williamjvest/milk-crate-dividers/README.md

# Milk crate dividers (Juggernaut 24 qt)

3D-printed clips that hold 1/4" plywood dividers in Juggernaut 24 quart milk crates. Each divider gets two **wall clips**, one on each side wall, and one **floor insert**. Everything plugs into the crate's own holes, so there's no glue and no drilling, and the crates still stack.

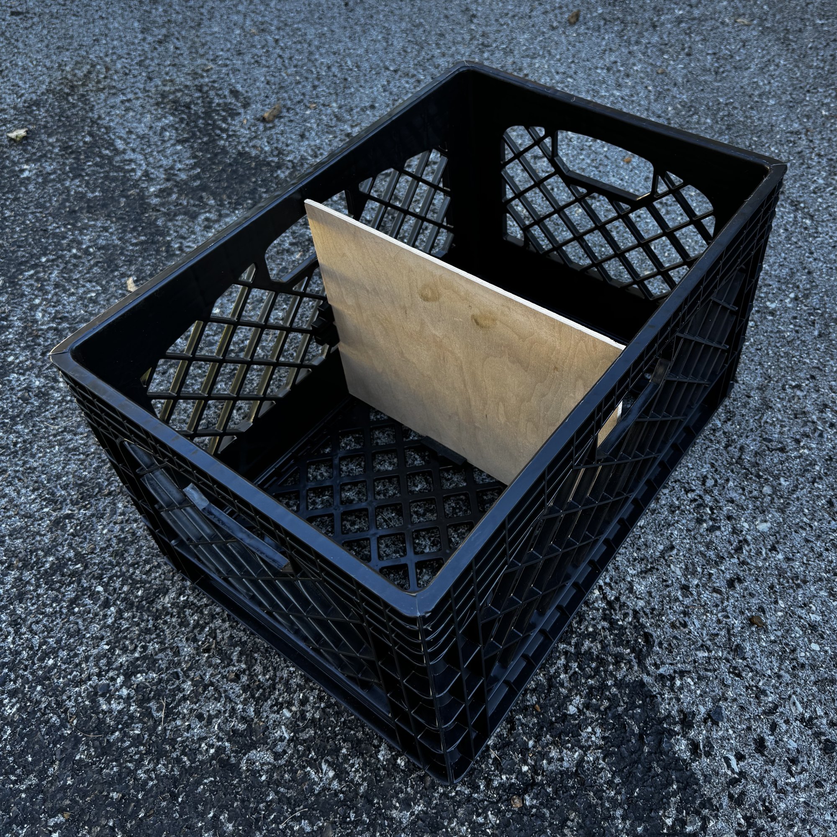
[picture p1: images/crate-angle.jpg]
A divider in a Juggernaut 24 qt crate


| | |
|---|---|
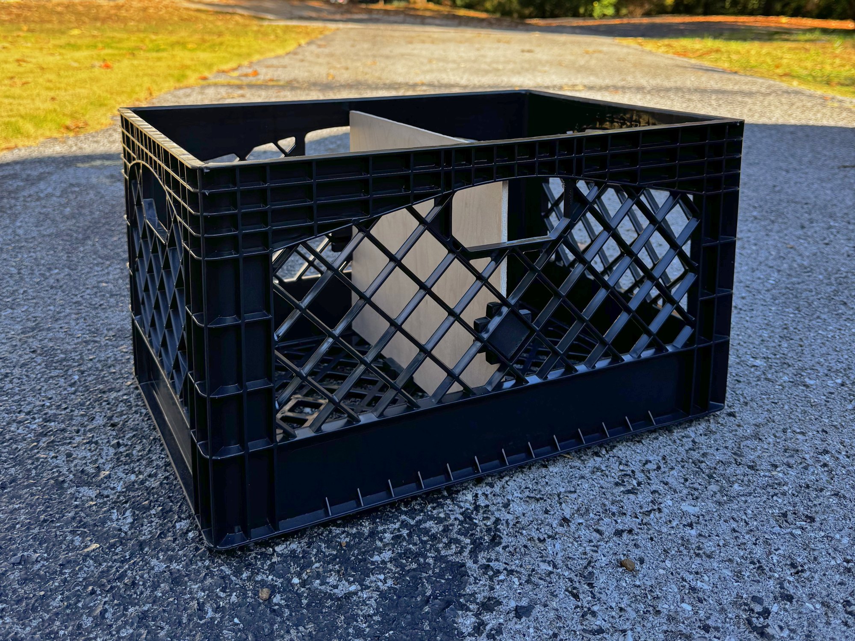
[picture p2: images/crate-side.jpg]
The crate from the side, divider in place
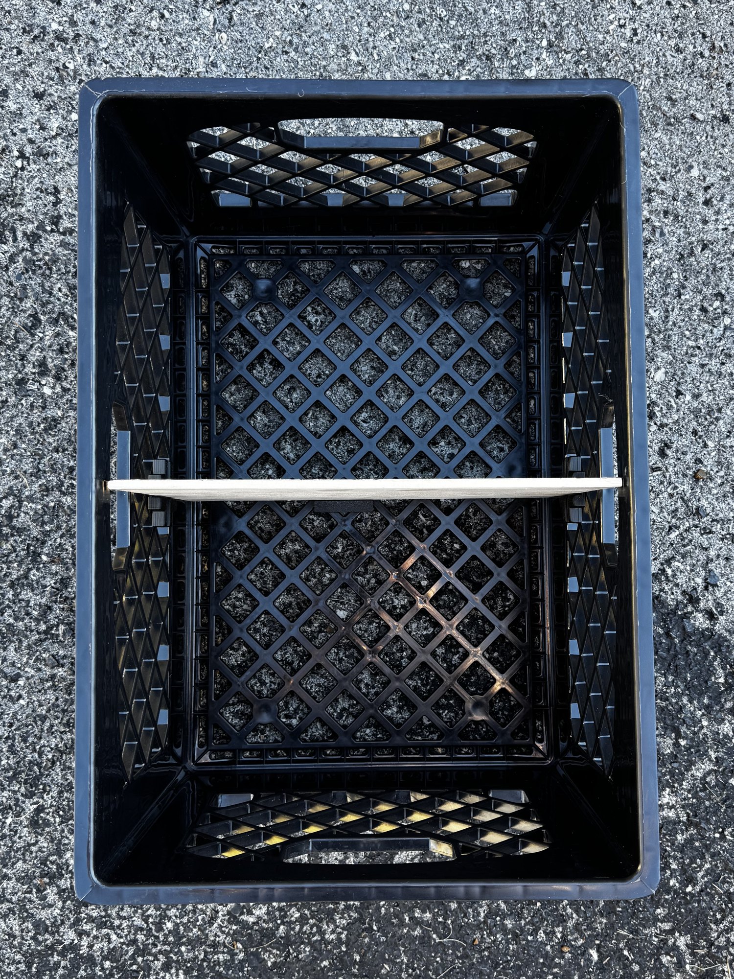
[picture p3: images/crate-top.jpg]
The crate from above: the board spans side wall to side wall
|  |  |

## What you need

| | |
|---|---|
| **Crates** | [Juggernaut 24 Quart Storage Crate, 6 pack](https://www.amazon.com/dp/B0D4BWD3GS) (Amazon) |
| **Board** | [1/4" x 4' x 8' Maple Square Sanded Plywood](https://www.lowes.com/pd/SoyStrong-NAF-1-4-in-HPVA-Maple-Plywood-Application-as-4-x-8/1000096494) (Lowe's item #786165, model #712807, about $37). It's an oversized 48-1/2" x 96-1/2" panel and actually 0.203" thick (5.2-5.4 mm). |
| **Per divider** | 1 board, 2 wall clips, 1 floor insert |
| **Printer** | Any FDM printer. PLA or PLA-CF. |

## Boards: 12" wide x 9-7/8" tall, 36 per sheet

Each board spans the crate's width, side wall to side wall, and splits it front to back. At 9-7/8" tall it sits just under the rim, so the crates still stack. The 4x8 sheet gives 4 rips of 12" with 9 boards each.

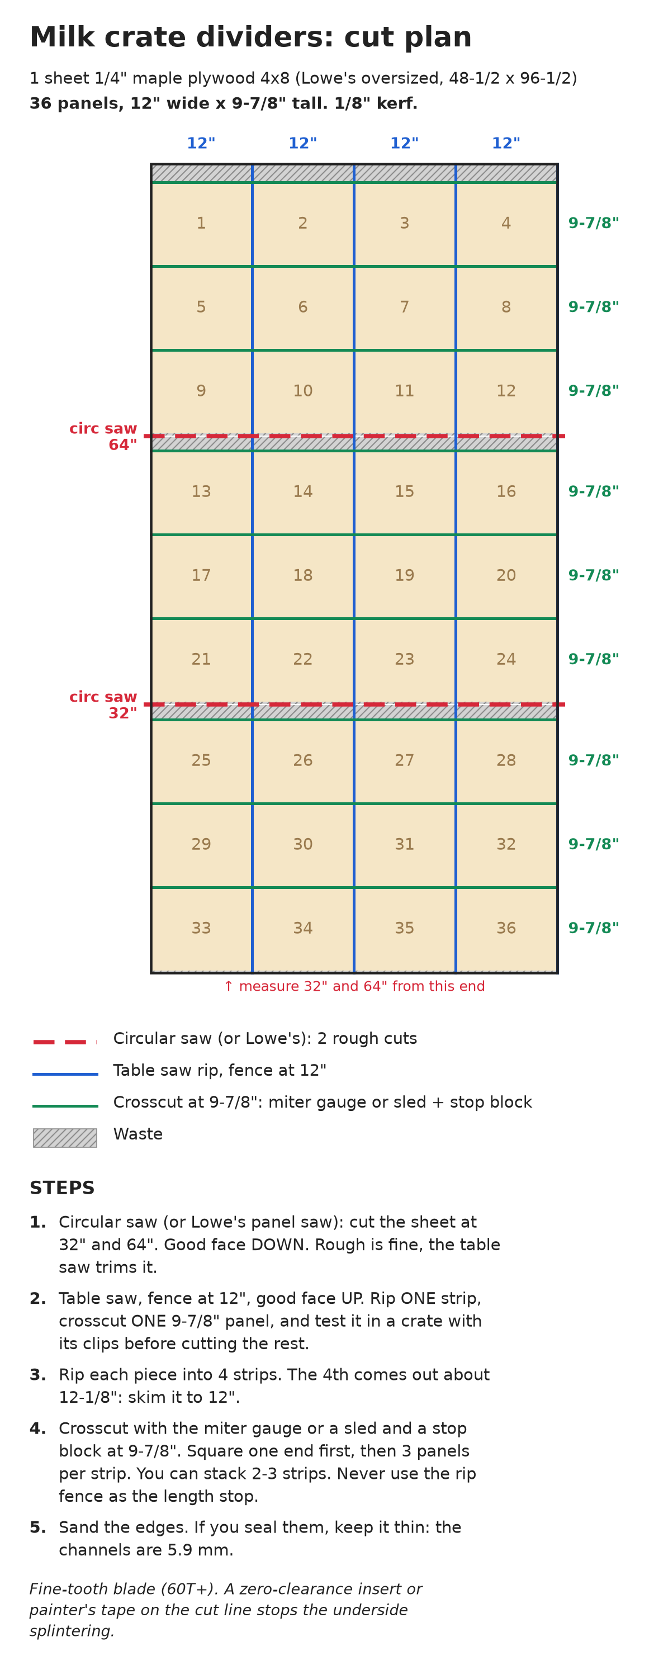
[picture p4: images/cut-plan.png]
Cut plan: 36 boards from one sheet


## Printing

Every print file is already oriented: channel face down, plug up. They need no supports.

- **3MF** is the one to use. It records units, so every slicer reads it at the right size (Orca, Bambu Studio, PrusaSlicer, Elegoo, Cura).
- **STL** works anywhere.
- **STEP**, in [`step/`](step), is for opening the parts in CAD.

| Part | 3MF | STL | Each (0.4 nozzle, 0.2 mm, PLA) |
|---|---|---|---|
| Wall clip | [`3mf/wall-clip.3mf`](3mf/wall-clip.3mf) | [`stl/wall-clip.stl`](stl/wall-clip.stl) | ~33 min, 12 g |
| Floor insert | [`3mf/floor-insert.3mf`](3mf/floor-insert.3mf) | [`stl/floor-insert.stl`](stl/floor-insert.stl) | ~30 min, 11 g |

- Print both as-is. Each part's two small "ears" carry the plug square up through the body, so nothing prints over air. The only bridge is the channel ceiling, 5.9 mm across.
- Print one of each and test-fit it in your crate before running a full plate. Crates and filaments vary.
- Six walls or 100% infill makes them stiff. Ours are printed in PLA and PLA-CF on an Elegoo Centauri Carbon.

## How it fits

| Wall clip | Floor insert |
|---|---|
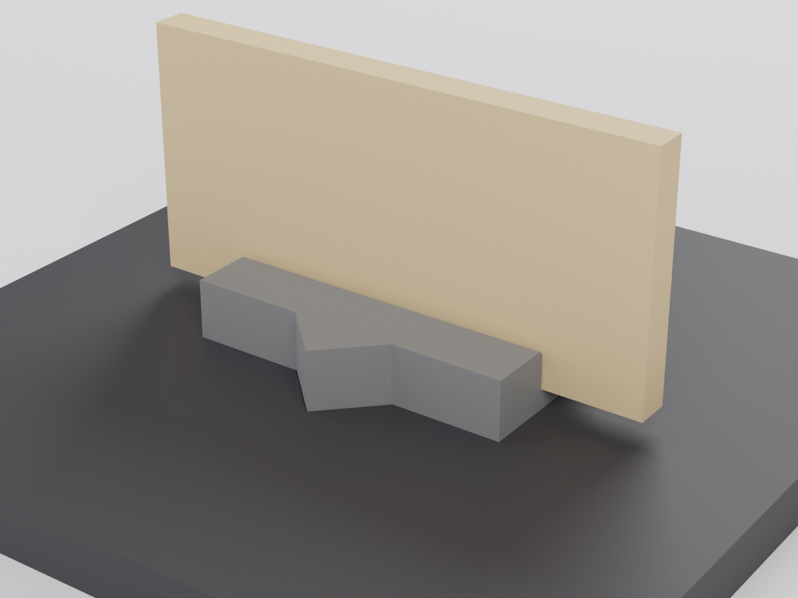
[picture p5: images/wall-clip-in-use.jpg]
Wall clip holding a board
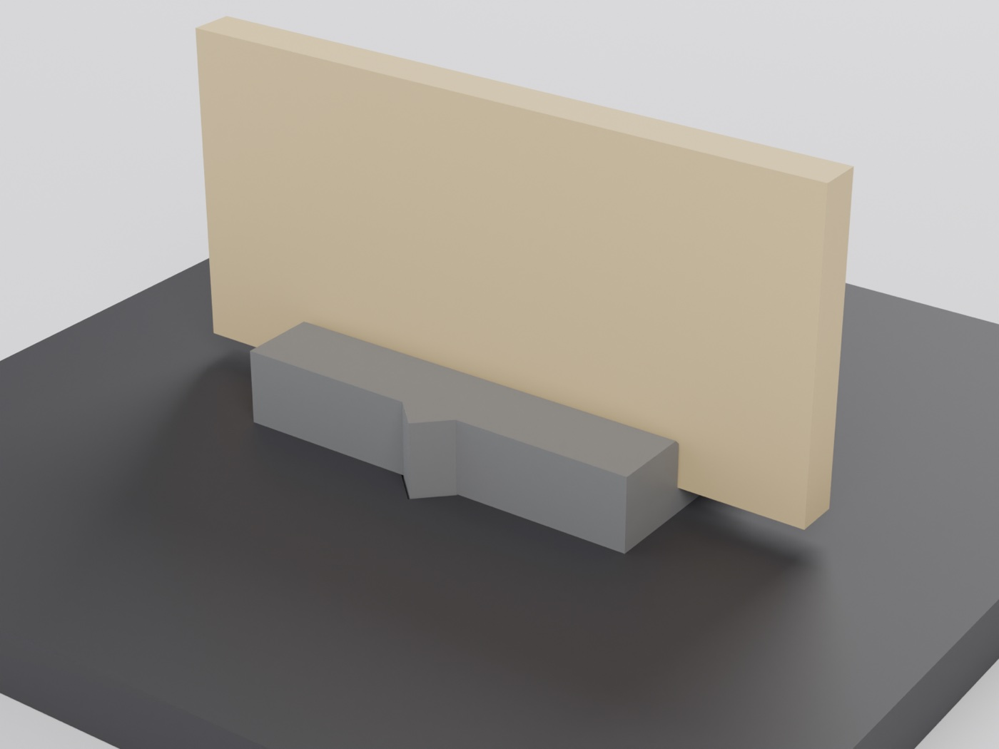
[picture p6: images/floor-insert-in-use.jpg]
Floor insert holding a board
|  |  |

| | Wall clip | Floor insert |
|---|---|---|
| Plug (a square turned 45° to match the crate's diamond holes) | 29.65 mm (1.17") across the flats | 23.4 mm (0.92") for the 23.9 mm floor holes |
| Channel | 5.9 mm wide x 6 mm deep | 5.9 mm wide x 6 mm deep |
| Body | 50 x 26 mm, 9 mm thick (42 mm across the ears) | 50 x 26 mm, 9 mm thick (33 mm across the ears) |

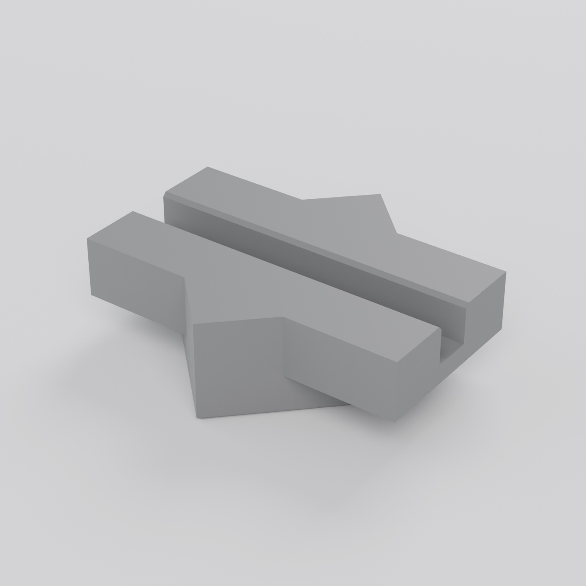
[picture p7: images/wall-clip-top.jpg]
Wall clip, channel side
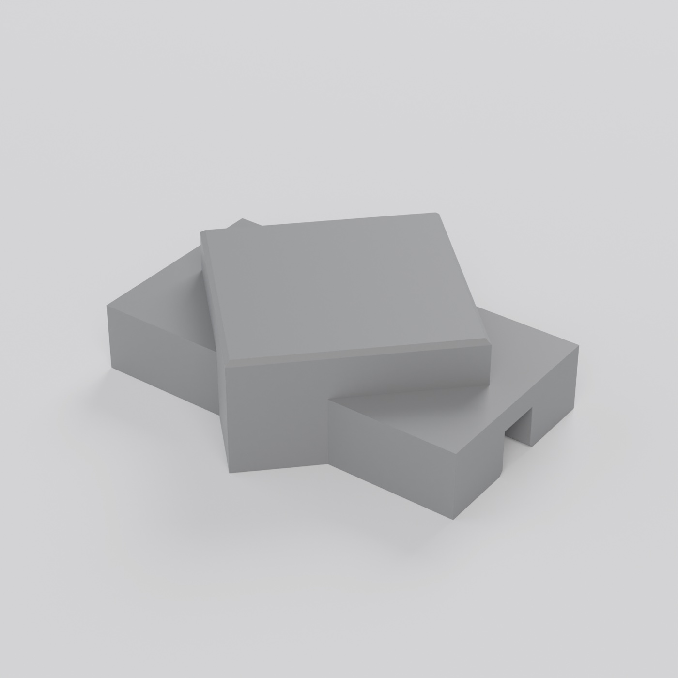
[picture p8: images/wall-clip-underside.jpg]
Wall clip, plug side
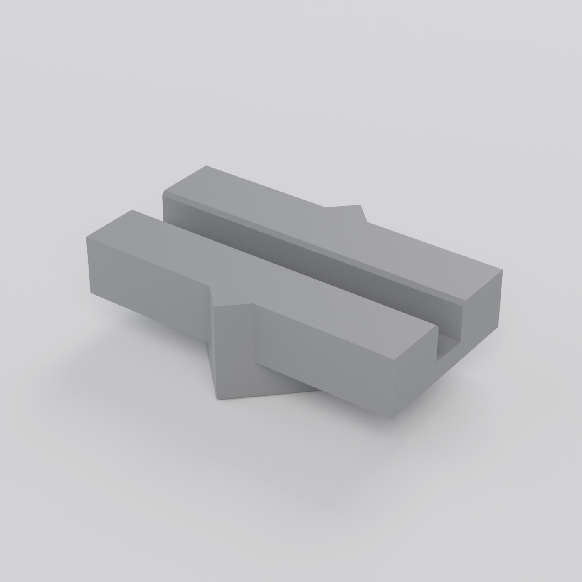
[picture p9: images/floor-insert-top.jpg]
Floor insert, channel side
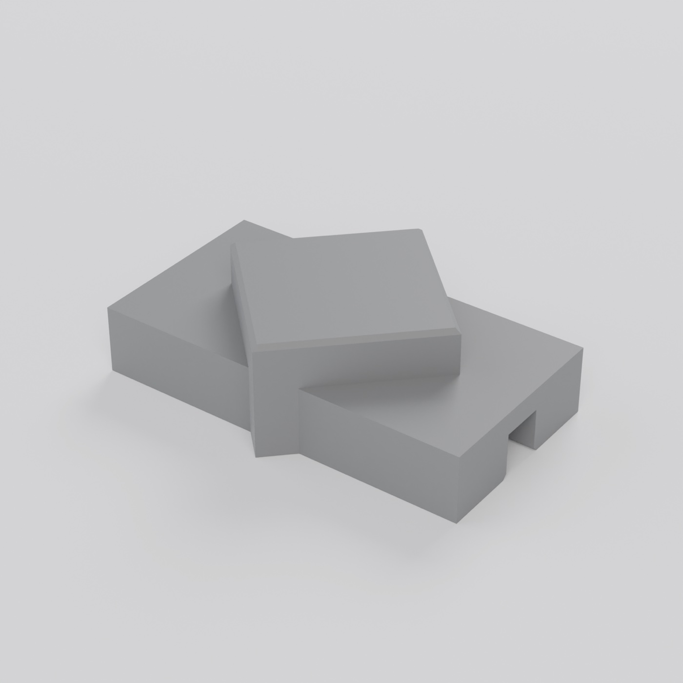
[picture p10: images/floor-insert-underside.jpg]
Floor insert, plug side
|  |  |  |  |
|---|---|---|---|
| Wall clip, channel side | Wall clip, plug side | Floor insert, channel side | Floor insert, plug side |

- **Plug fit:** the floor insert's plug is snug by design. If yours won't go in, sand the flats lightly, or drop `PLUG` by 0.1-0.2 mm in the script.
- **Channel:** 5.9 mm leaves about 0.3 mm a side for the 1/4" maple. For 6 mm material (Baltic birch, Sintra, BCX pine), set `SLOT_W = 6.5` in both scripts.
- **Height:** the floor insert lifts the board 3 mm off the crate floor.
- **Shelves:** the plugs are square, so a wall clip turned 90° holds a horizontal board.

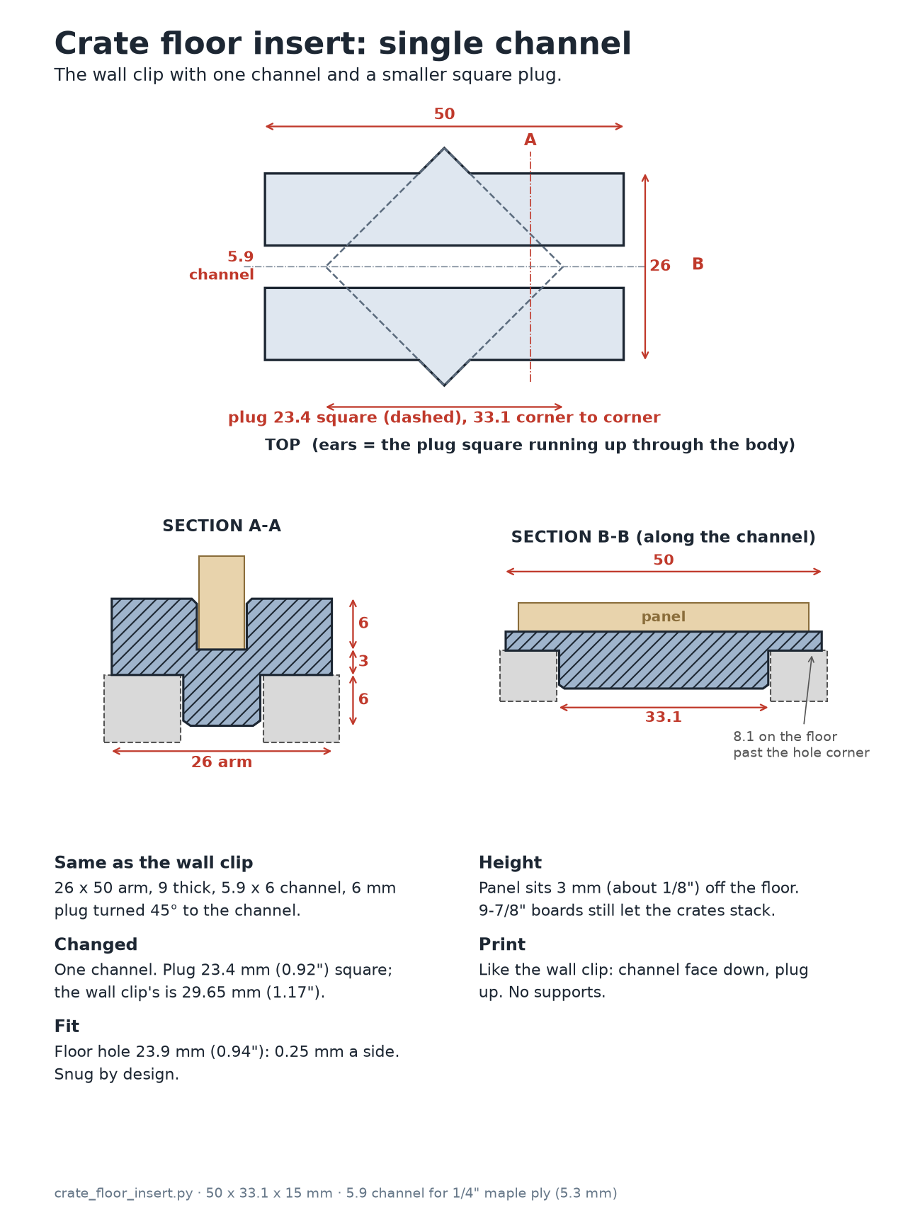
[picture p11: images/floor-insert-blueprint.png]
Floor insert drawing


## Changing the parts

[`cad/`](cad) has the parametric source, written in [build123d](https://github.com/gumyr/build123d). Every dimension is a named parameter at the top of each script, with a comment saying why it has that value.

```bash
pip install -r cad/requirements.txt
cd cad
python crate_wall_clip.py      # writes crate-wall-clip.step / .stl / _print.stl / _print.3mf
python crate_floor_insert.py   # writes crate-floor-insert.step / .stl / _print.stl / _print.3mf
python cut_plan.py ../images/cut-plan.png
```

## Credits and license

The wall clip is a remix of [Milk Crate Divider by robthewinner](https://www.printables.com/model/34329-milk-crate-divider), licensed CC BY-NC 4.0. This version changes four things:
- It's rebuilt as a parametric script.
- It has one channel instead of the cross, which saves about 15% of the plastic.
- The plug is resized for the Juggernaut crate's holes.
- The channel is narrowed to 5.9 mm for 1/4" plywood.

The single-channel floor insert is new.

Everything here is licensed [CC BY-NC 4.0](LICENSE.md). Share and remix it with attribution, but not commercially.
