williamjvest/milk-crate-dividers/step/wall-clip.step

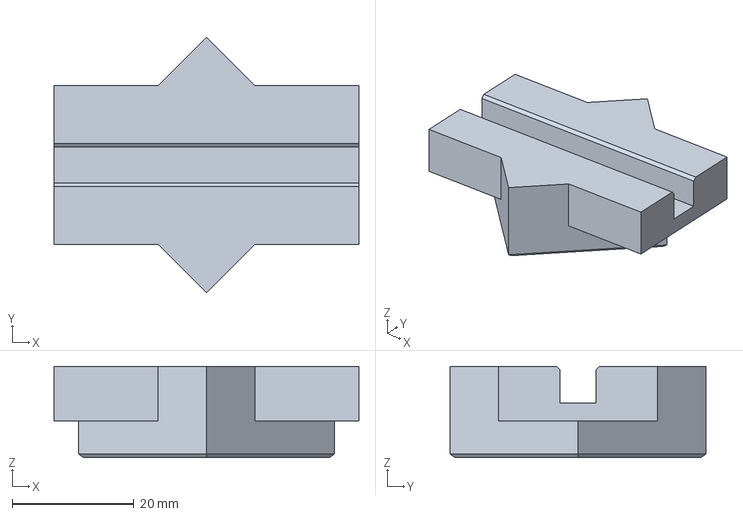
[picture p12: CAD file, 2026-11-08]
step/wall-clip.step
50.0 x 41.9 x 15.0 mm
