williamjvest/milk-crate-dividers/step/floor-insert.step

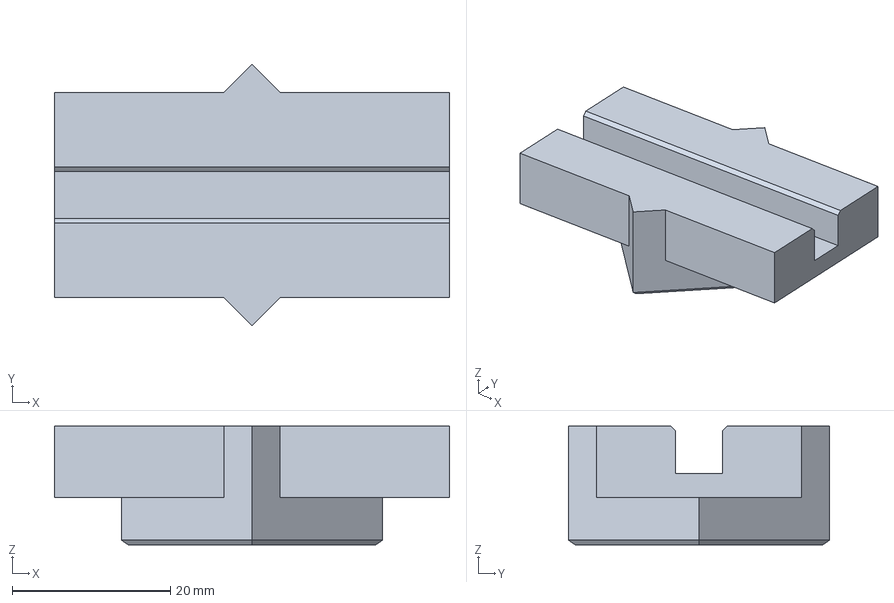
[picture p13: CAD file, 2026-11-08]
step/floor-insert.step
50.0 x 33.1 x 15.0 mm
