williamjvest/milk-crate-dividers/(list of files, cad)

Other CAD files:
3mf/floor-insert.3mf
3mf/wall-clip.3mf
stl/floor-insert.stl
stl/wall-clip.stl
