williamjvest/milk-crate-dividers/(commit log)

2026-11-08 Milk crate dividers for Juggernaut 24 qt crates: wall clip, floor insert, cut plan
    [floor-insert.step, floor-insert.stl, wall-clip.step, wall-clip.stl]
2026-11-08 Wall clip: single channel like the floor insert (16.3 vs 19.1 cm3, ~33 min / 12 g)
    [wall-clip.step, wall-clip.stl]
2026-11-08 3MF print files for both parts (units in mm; sliced-checked in ElegooSlicer)
    [floor-insert.3mf, wall-clip.3mf]
2026-11-09 README: test-fit one of each before a full plate
